tguyenn/drone-swarm/README.md

# Drone Swarm

This project is going to be a fully DIY drone swarm project based around ESP32 connectivity. There will be an ESP32 based handheld controller that will connect to ESP32 based drones over ESPNOW.
