tguyenn/drone-swarm/hardware/remote/controller.kicad_pcb

## KiCad design hardware/remote/controller.kicad_pcb (2026-08-26)

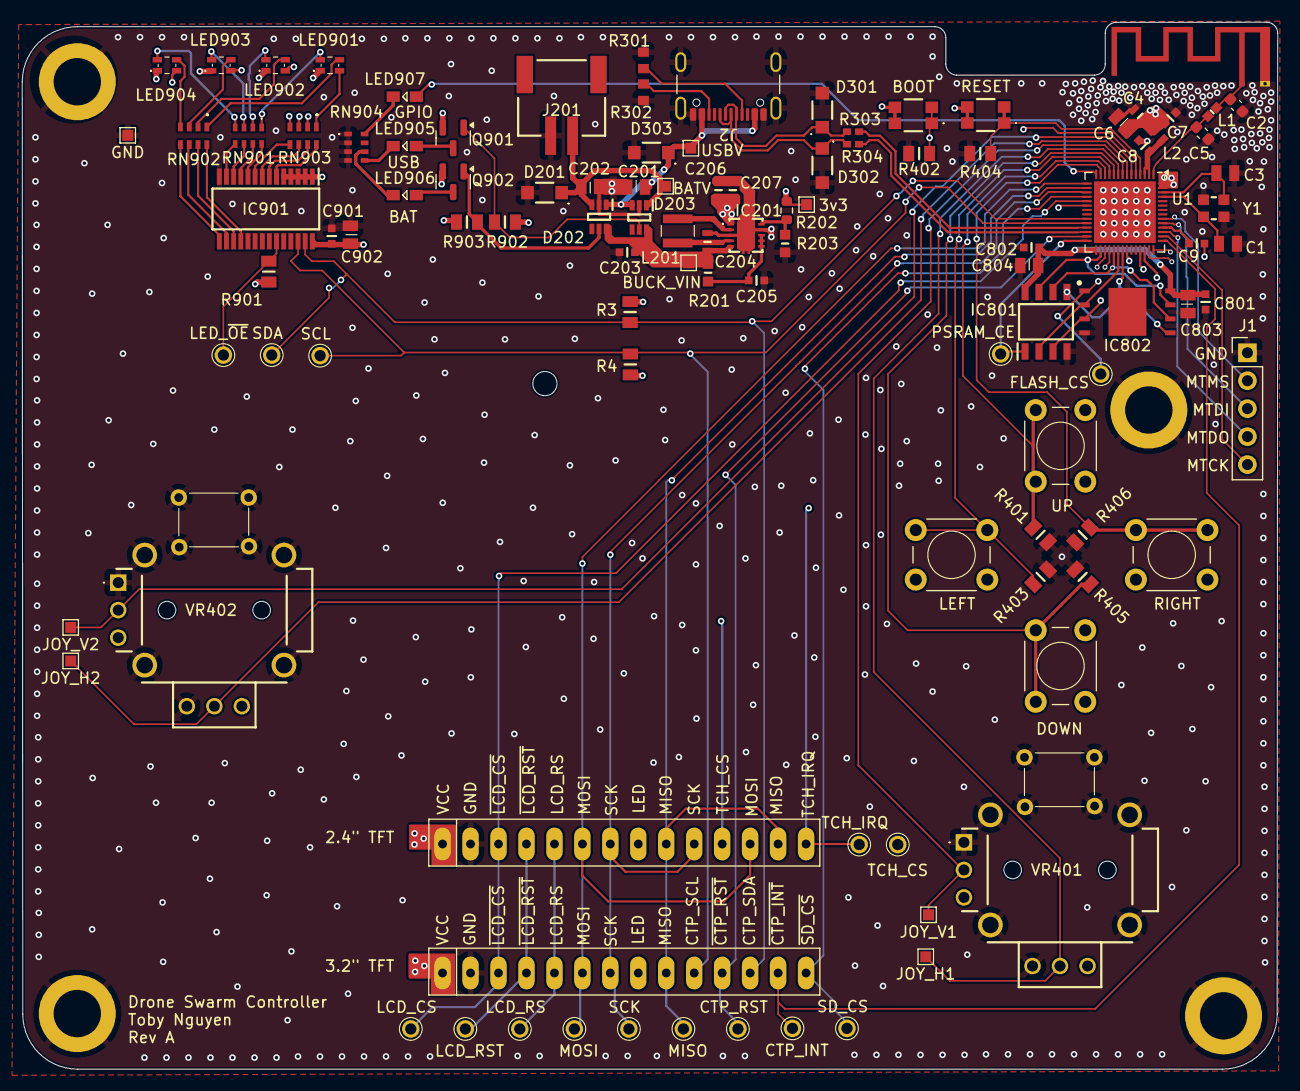
[picture p1: board controller.kicad_pcb from above]

Board: 4 copper layers, 114.0 x 95.1 mm, 113 parts (0 on the bottom side), 90 nets.

Parts:
AE1: Antenna_Chip; Texas_SWRA117D_2.4GHz_Left
C1, C3: 10p; CAPC2013X94N
C2, C5: 1p8; C_0603_1608Metric
C4, C204, C206, C207: 10u; CAPC1608X80N
C6, C201, C202, C803, C804, C902: 1u; CAPC2012X135N
C7, C8, C9, C203, C205, C801, C802, C901: u1; MAJx16
D201, D301, D302, D303: SMF5.0A_R1_00001; SMF50A_R1_00001
D202, D203: LM66100DCKR; SOP65P210X110-6N
H101: MountingHole; MountingHole_2.2mm_M2_DIN965
H102, H103, H104, H105: MountingHole_Pad; MountingHole_4.3mm_M4_ISO14580_Pad
IC201: TPS63000IDRCRQ1
IC801: 4677; SOIC127P600X175-8N
IC802: W25Q256JVEIQ; SON127P800X600X80-9N-D
IC901: PCA9685PW_Q900,118; SOP65P640X110-28N
J1: Conn_01x05_Pin; PinHeader_1x05_P2.54mm_Vertical
J2: USB_C_Receptacle_USB2.0_16P; USB_C_Receptacle_GCT_USB4105-xx-A_16P_TopMnt_Horizontal
J201: JST-PH Conn; 1769
L1: 3nH; INDC1006X65N
L2: 2nH; WE-KI_0603A30
L201: 2u2; NRS3015T2R2MNGHV
LED901, LED902, LED903, LED904: SM0605RGB
LED905, LED906, LED907: Orange; LEDM2214X140N
NT201: NetTie; NetTie-2_Pad0.3mm
Q901, Q902: IRLML6402TRPBF; SOT-23
R3, R4, R401, R402, R403, R404, R405, R406, R901, R902, R903: 10k; RESC2012X60N
R201: 100; RESC1608X55N
R202: 1M; R_0603_1608Metric
R203: 200k; RESC1608X55N
R301, R302: 5k1; RESC1608X50N
R303, R304: 27; RESC1005X40N
RN901, RN904: 150 Ohms; EXBV8V151JV
RN902, RN903: 100 Ohms; EXBU38
S401: BOOT; TL1030AF500AQJ
S402: RESET; TL1030AF500AQJ
SW401: UP; SW_PUSH_6mm
SW402: LEFT; SW_PUSH_6mm
SW403: DOWN; SW_PUSH_6mm
SW404: RIGHT; SW_PUSH_6mm
TP3: MOSI; 5000
TP5: SDA; 5000
TP6: MISO; 5000
TP8: SCL; 5000
TP9: SCK; 5000
TP10: CTP_RST; 5000
TP11: SD_CS; 5000
TP12: CTP_INT; 5000
TP13: LCD_CS; 5000
TP14: LED_~{OE}; 5000
TP15: LCD_RST; 5000
TP16: LCD_RS; 5000
TP17: TCH_CS; 5000
TP18: TCH_IRQ; 5000
TP201: BATV; TestPoint_Pad_1.0x1.0mm
TP202: GND; TestPoint_Pad_1.0x1.0mm
TP203: 3v3; TestPoint_Pad_1.0x1.0mm
TP204: USBV; TestPoint_Pad_1.0x1.0mm
TP205: BUCK_VIN; TestPoint_Pad_1.0x1.0mm
TP401: JOY_V1; TestPoint_Pad_1.0x1.0mm
TP402: JOY_H1; TestPoint_Pad_1.0x1.0mm
TP403: JOY_V2; TestPoint_Pad_1.0x1.0mm
TP404: JOY_H2; TestPoint_Pad_1.0x1.0mm
TP801: PSRAM_CE; 5000
TP802: FLASH_CS; 5000
U1: ESP32-S3; QFN-56-1EP_7x7mm_P0.4mm_EP5.6x5.6mm
U501, U502: 3.2inch_IPS_SPI_Module_ILI9341; TFT-320x240
VR401, VR402: RKJXV1224005
Y1: FH4000074Z

Connections:
+3V3: C4.1, C6.1, C7.1, C9.1, C206.1, C207.1, C901.1, C902.1, IC201.1 (VOUT), IC901.1 (A0), IC901.2 (A1), IC901.3 (A2), IC901.4 (A3), IC901.5 (A4), IC901.28 (VDD), L2.1, LED901.1 (ANODE), LED902.1 (ANODE), LED903.1 (ANODE), LED904.1 (ANODE), Q901.2 (S), Q902.2 (S), R3.2, R4.2, R202.1, R901.1, R902.2, R903.2, S401.2, S402.2, SW401.2, SW402.2, SW403.2, SW404.2, TP203.1, U1.20 (VDD3P3_RTC), U1.55 (VDDA), U1.56 (VDDA), U501.1 (VCC), U502.1 (VCC), VR401.A3 (CW_1), VR401.B3 (CW_2), VR402.A3 (CW_1), VR402.B3 (CW_2)
/ESP32/BUT_JOY.BUT_BOOT: R402.1, S401.1, U1.5 (GPIO0/BOOT)
/ESP32/BUT_JOY.BUT_DOWN: R405.1, SW403.1, U1.10 (GPIO5/ADC1_CH4)
/ESP32/BUT_JOY.BUT_LEFT: R403.1, SW402.1, U1.11 (GPIO6/ADC1_CH5)
/ESP32/BUT_JOY.BUT_RESET: R404.1, S402.1, U1.4 (CHIP_PU/RESET)
/ESP32/BUT_JOY.BUT_RIGHT: R406.1, SW404.1, U1.13 (GPIO8/ADC1_CH7)
/ESP32/BUT_JOY.BUT_UP: R401.1, SW401.1, U1.12 (GPIO7/ADC1_CH6)
/ESP32/BUT_JOY.JOY1_H: TP402.1, U1.9 (GPIO4/ADC1_CH3), VR401.B2 (WIPER_2)
/ESP32/BUT_JOY.JOY1_V: TP401.1, U1.8 (GPIO3/ADC1_CH2), VR401.A2 (WIPER_1)
/ESP32/BUT_JOY.JOY2_H: TP404.1, U1.7 (GPIO2/ADC1_CH1), VR402.B2 (WIPER_2)
/ESP32/BUT_JOY.JOY2_V: TP403.1, U1.6 (GPIO1/ADC1_CH0), VR402.A2 (WIPER_1)
/ESP32/I2C_CTP_LED.CTP_INT: TP12.1, U1.43 (GPIO38), U501.13 (~CTP_INT)
/ESP32/I2C_CTP_LED.CTP_RST: TP10.1, U1.27 (GPIO21), U501.11 (~CTP_RST)
/ESP32/I2C_CTP_LED.SCL: IC901.26 (SCL), R4.1, TP8.1, U1.24 (GPIO18/ADC2_CH7), U501.10 (CTP_SCL)
/ESP32/I2C_CTP_LED.SDA: IC901.27 (SDA), R3.1, TP5.1, U1.23 (GPIO17/ADC2_CH6), U501.12 (CTP_SDA)
/ESP32/I2C_CTP_LED.~OE: IC901.23 (~OE), R901.2, TP14.1, U1.36 (SPICLK_N/GPIO48)
/ESP32/LED_GPIO: LED907.2 (A), U1.14 (GPIO9/ADC1_CH8)
/ESP32/MEM.SCK: IC801.6 (SCLK), IC802.6 (CLK), U1.33 (SPICLK/GPIO30)
/ESP32/MEM.SIO0: IC801.5 (SI/SIO[0]), IC802.5 (DI_(IO0)), U1.35 (SPID/GPIO32)
/ESP32/MEM.SIO1: IC801.2 (SO/SIO[1]), IC802.2 (DO_(IO1)_1), U1.34 (SPIQ/GPIO31)
/ESP32/MEM.SIO2: IC801.3 (SIO[2]), IC802.3 (DO_(IO1)_2), U1.31 (SPIWP/GPIO28)
/ESP32/MEM.SIO3: IC801.7 (SIO[3]), IC802.7 (IO3), U1.30 (SPIHD/GPIO27)
/ESP32/MEM.~CE: IC801.1 (CE#), TP801.1, U1.28 (SPI_CS1/GPIO26)
/ESP32/MEM.~CS: IC802.1 (/CS), TP802.1, U1.32 (SPICS0/GPIO29)
/ESP32/MTCK: J1.5, U1.44 (MTCK/JTAG/GPIO39)
/ESP32/MTDI: J1.3, U1.47 (MTDI/JTAG/GPIO41)
/ESP32/MTDO: J1.4, U1.45 (MTDO/JTAG/GPIO40)
/ESP32/MTMS: J1.2, U1.48 (MTMS/JTAG/GPIO42)
/ESP32/SPI_LCD_SD.LCD_CS: TP13.1, U1.19 (GPIO14/ADC2_CH3), U501.3 (~LCD_CS), U502.3 (~LCD_CS)
/ESP32/SPI_LCD_SD.LCD_RS: TP16.1, U1.42 (GPIO37), U501.5 (LCD_RS), U502.5 (LCD_RS)
/ESP32/SPI_LCD_SD.LCD_RST: TP15.1, U1.41 (GPIO36), U501.4 (~LCD_RST), U502.4 (~LCD_RST)
/ESP32/SPI_LCD_SD.MISO: TP6.1, U1.16 (GPIO11/ADC2_CH0), U501.9 (MISO), U502.9 (MISO), U502.13 (T_DO)
/ESP32/SPI_LCD_SD.MOSI: TP3.1, U1.15 (GPIO10/ADC1_CH9), U501.6 (MOSI), U502.6 (MOSI), U502.12 (T_DIN)
/ESP32/SPI_LCD_SD.SCK: TP9.1, U1.17 (GPIO12/ADC2_CH1), U501.7 (SCK), U502.7 (SCK), U502.10 (T_CLK)
/ESP32/SPI_LCD_SD.SD_CS: TP11.1, U1.18 (GPIO13/ADC2_CH2), U501.14 (~SD_CS)
/ESP32/SPI_LCD_SD.TCH_CS: TP17.1, U1.40 (GPIO35), U502.11 (T_CS)
/ESP32/SPI_LCD_SD.TCH_IRQ: TP18.1, U1.39 (GPIO34), U502.14 (T_IRQ)
/ESP32/USB+: R304.2, U1.26 (GPIO20/USB_D+/ADC2_CH9)
/ESP32/USB-: R303.2, U1.25 (GPIO19/USB_D-/ADC2_CH8)
/LEDS/B1: LED901.2 (C_BLUE), RN903.1
/LEDS/B2: LED902.2 (C_BLUE), RN903.2
/LEDS/B3: LED903.2 (C_BLUE), RN903.3
/LEDS/B4: LED904.2 (C_BLUE), RN903.4
/LEDS/BAT_ST: D203.5 (ST), Q901.1 (G), R902.1
/LEDS/C_BLU1: IC901.6 (LED0), RN903.8
/LEDS/C_BLU2: IC901.7 (LED1), RN903.7
/LEDS/C_BLU3: IC901.8 (LED2), RN903.6
/LEDS/C_BLU4: IC901.9 (LED3), RN903.5
/LEDS/C_GRN1: IC901.18 (LED11), RN902.8
/LEDS/C_GRN2: IC901.17 (LED10), RN902.7
/LEDS/C_GRN3: IC901.16 (LED9), RN902.6
/LEDS/C_GRN4: IC901.15 (LED8), RN902.5
/LEDS/C_RED1: IC901.10 (LED4), RN901.8
/LEDS/C_RED2: IC901.11 (LED5), RN901.7
/LEDS/C_RED3: IC901.12 (LED6), RN901.6
/LEDS/C_RED4: IC901.13 (LED7), RN901.5
/LEDS/G1: LED901.4 (C_GREEN), RN902.1
/LEDS/G2: LED902.4 (C_GREEN), RN902.2
/LEDS/G3: LED903.4 (C_GREEN), RN902.3
/LEDS/G4: LED904.4 (C_GREEN), RN902.4
/LEDS/R1: LED901.3 (C_RED), RN901.1
/LEDS/R2: LED902.3 (C_RED), RN901.2
/LEDS/R3: LED903.3 (C_RED), RN901.3
/LEDS/R4: LED904.3 (C_RED), RN901.4
/LEDS/USBC_ST: D202.5 (ST), Q902.1 (G), R903.1
/POWER/BAT_VBUS: C202.1, D201.1 (K), D202.3 (~CE), D203.1 (VIN), J201.1, TP201.1
/POWER/BUCK_VIN: C203.1, C204.1, D202.6 (VOUT), D203.6 (VOUT), IC201.5 (VIN), R201.1, TP205.1
/POWER/USBC_VBUS: C201.1, D202.1 (VIN), D203.3 (~CE), D303.1 (K), J2.A4 (VBUS), J2.A9 (VBUS), J2.B4 (VBUS), J2.B9 (VBUS), TP204.1
/USBC/CC1: J2.A5 (CC1), R301.1
/USBC/CC2: J2.B5 (CC2), R302.1
/USBC/D+: D302.1 (K), J2.A6 (D+), J2.B6 (D+), R304.1
/USBC/D-: D301.1 (K), J2.A7 (D-), J2.B7 (D-), R303.1
GND: AE1.2 (PCB_Trace), C1.2, C2.2, C3.2, C4.2, C5.2, C6.2, C7.2, C8.2, C201.2, C202.2, C203.2, C205.2, C801.2, C802.2, C803.2, C804.2, C901.2, C902.2, D201.2 (A), D202.2 (GND), D203.2 (GND), D301.2 (A), D302.2 (A), D303.2 (A), H102.1, H103.1, H104.1, H105.1, IC201.9 (GND), IC801.4 (VSS), IC802.4 (GND), IC802.9 (EP), IC901.14 (VSS), J1.1, J2.A1 (GND), J2.A12 (GND), J2.B1 (GND), J2.B12 (GND), J2.S1 (SHIELD), J201.2, NT201.1, R203.2, R301.2, R302.2, R401.2, R402.2, R403.2, R404.2, R405.2, R406.2, RN904.1, RN904.2, RN904.3, RN904.4, TP202.1, U1.57 (GND), U501.2 (GND), U502.2 (GND), VR401.1 (MH1), VR401.2 (MH2), VR401.3 (MH3), VR401.4 (MH4), VR401.5 (BUT_0), VR401.6 (BUT_1), VR401.A1 (CCW_1), VR401.B1 (CCW_2), VR402.1 (MH1), VR402.2 (MH2), VR402.3 (MH3), VR402.4 (MH4), VR402.5 (BUT_0), VR402.6 (BUT_1), VR402.A1 (CCW_1), VR402.B1 (CCW_2), Y1.2 (GND), Y1.4 (GND)
GNDPWR: C204.2, C206.2, C207.2, IC201.3 (PGND_1), IC201.11 (PGND_2), IC201.12 (PGND_3), IC201.13 (PGND_4), IC201.14 (PGND_5), IC201.15 (PGND_6), NT201.2
unnamed: AE1.1 (FEED), C2.1, L1.1
unnamed: C205.1, IC201.6 (EN), IC201.7 (PS/SYNC), IC201.8 (VINA), R201.2
unnamed: IC201.10 (FB), R202.2, R203.1
unnamed: IC201.4 (L1), L201.1
unnamed: IC201.2 (L2), L201.2
unnamed: LED905.2 (A), Q901.3 (D)
unnamed: LED905.1 (K), RN904.5
unnamed: LED906.2 (A), Q902.3 (D)
unnamed: LED906.1 (K), RN904.6
unnamed: LED907.1 (K), RN904.8
unnamed: C5.1, L1.2, U1.1 (LNA_IN/RF)
unnamed: C9.2, U1.46 (VDD3P3_CPU)
unnamed: C1.1, U1.53 (XTAL_N), Y1.3 (XOUT)
unnamed: C3.1, U1.54 (XTAL_P), Y1.1 (XIN)
VDD3P3: C8.1, L2.2, U1.2 (VDD3P3), U1.3 (VDD3P3)
VDD_SPI: C801.1, C802.1, C803.1, C804.1, IC801.8 (VCC), IC802.8 (VCC), U1.29 (VDD_SPI)
