tguyenn/drone-swarm/hardware/flight_controller/drone.kicad_pcb

## KiCad design hardware/flight_controller/drone.kicad_pcb (2025-09-21)

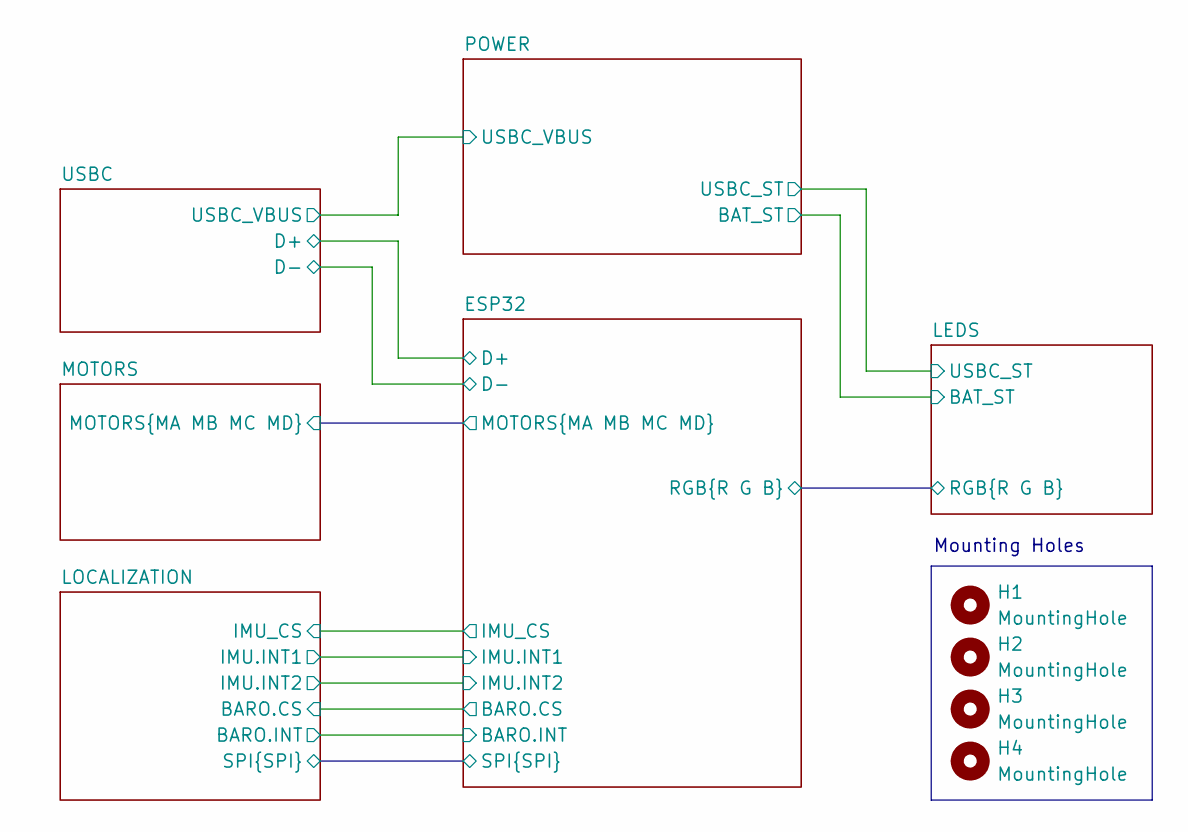
[picture p2: schematic drone.kicad_sch, Remote Controller]

Parts:
H1, H2, H3, H4: MountingHole; MountingHole_2.1mm

Notes on the sheet:
Mounting Holes

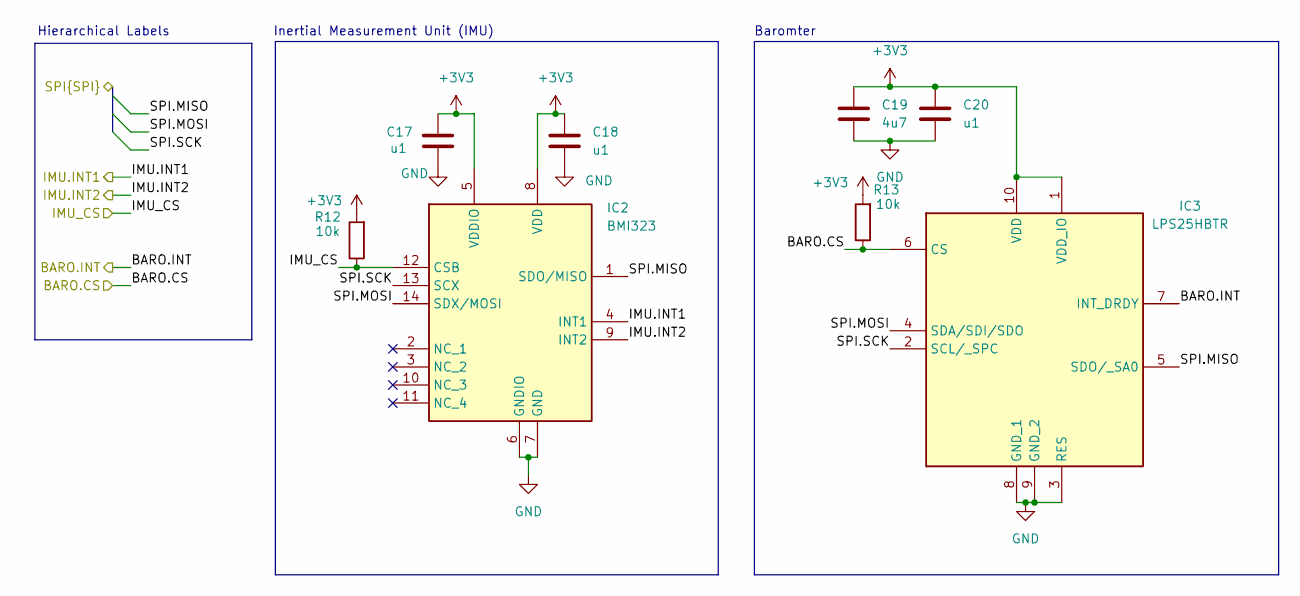
[picture p3: schematic IMU.kicad_sch]

Parts:
C17, C18, C20: u1; MAJx16; Mouser Part Number 963-MAJCH168BB7104KT
C19: 4u7; CAPC1608X90N; Manufacturer_Part_Number AMK107BJ475MA-T
IC2: BMI323; Mouser Part Number 262-BMI323
IC3: LPS25HBTR; Mouser Part Number 511-LPS25HBTR
R12, R13: 10k; RESC2012X60N; Manufacturer_Part_Number ASC0805-10KFT5; Mouser Part Number 756-ASC0805-10KFT5

Connections:
+3V3: C17.1, C18.1, C19.1, C20.1, IC2.5 (VDDIO), IC2.8 (VDD), IC3.1 (VDD_IO), IC3.10 (VDD), R12.2, R13.2; also elsewhere on the board
/ESP32/BARO.CS: IC3.6 (CS), R13.1; also elsewhere on the board
/ESP32/BARO.INT: IC3.7 (INT_DRDY); also elsewhere on the board
/ESP32/IMU.INT1: IC2.4 (INT1); also elsewhere on the board
/ESP32/IMU.INT2: IC2.9 (INT2); also elsewhere on the board
/ESP32/IMU_CS: IC2.12 (CSB), R12.1; also elsewhere on the board
/ESP32/SPI.MISO: IC2.1 (SDO/MISO), IC3.5 (SDO/_SA0); also elsewhere on the board
/ESP32/SPI.MOSI: IC2.14 (SDX/MOSI), IC3.4 (SDA/SDI/SDO); also elsewhere on the board
/ESP32/SPI.SCK: IC2.13 (SCX), IC3.2 (SCL/_SPC); also elsewhere on the board
GND: C17.2, C18.2, C19.2, C20.2, IC2.6 (GNDIO), IC2.7 (GND), IC3.3 (RES), IC3.8 (GND_1), IC3.9 (GND_2); also elsewhere on the board

Notes on the sheet:
Baromter
Hierarchical Labels
Inertial Measurement Unit (IMU)

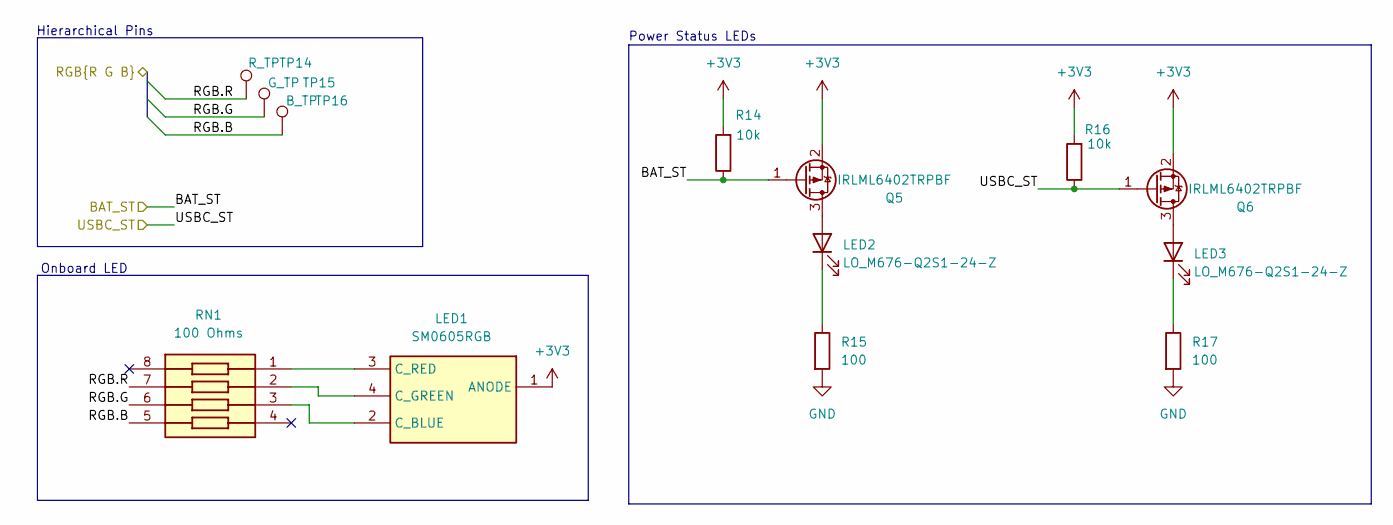
[picture p4: schematic LEDS.kicad_sch]

Parts:
LED1: SM0605RGB; Mouser Part Number 749-SM0605TCRGB
LED2, LED3: LO_M676-Q2S1-24-Z; LEDM2214X140N; Mouser Part Number 720-LOM676Q2S124Z
Q5, Q6: IRLML6402TRPBF; SOT-23; Mouser Part Number 942-IRLML6402TRPBF
R14, R16: 10k; RESC2012X60N; Manufacturer_Part_Number ASC0805-10KFT5; Mouser Part Number 756-ASC0805-10KFT5
R15, R17: 100; RESC1608X55N; Mouser Part Number 755-ESR03EZPF1000
RN1: 100 Ohms; EXBU38; Mouser Part Number 667-EXB-U38101JV
TP14: R_TP; TestPoint_Pad_1.0x1.0mm
TP15: G_TP; TestPoint_Pad_1.0x1.0mm
TP16: B_TP; TestPoint_Pad_1.0x1.0mm

Connections:
+3V3: LED1.1 (ANODE), Q5.2 (S), Q6.2 (S), R14.2, R16.2; also elsewhere on the board
/ESP32/RGB.B: RN1.5, TP16.1; also elsewhere on the board
/ESP32/RGB.G: RN1.6, TP15.1; also elsewhere on the board
/ESP32/RGB.R: RN1.7, TP14.1; also elsewhere on the board
/LEDS/BAT_ST: Q5.1 (G), R14.1; also elsewhere on the board
/LEDS/USBC_ST: Q6.1 (G), R16.1; also elsewhere on the board
GND: R15.2, R17.2; also elsewhere on the board
unnamed: LED1.2 (C_BLUE), RN1.3
unnamed: LED1.4 (C_GREEN), RN1.2
unnamed: LED1.3 (C_RED), RN1.1
unnamed: LED2.2 (A), Q5.3 (D)
unnamed: LED2.1 (K), R15.1
unnamed: LED3.2 (A), Q6.3 (D)
unnamed: LED3.1 (K), R17.1

Notes on the sheet:
Onboard LED
Hierarchical Pins
Power Status LEDs

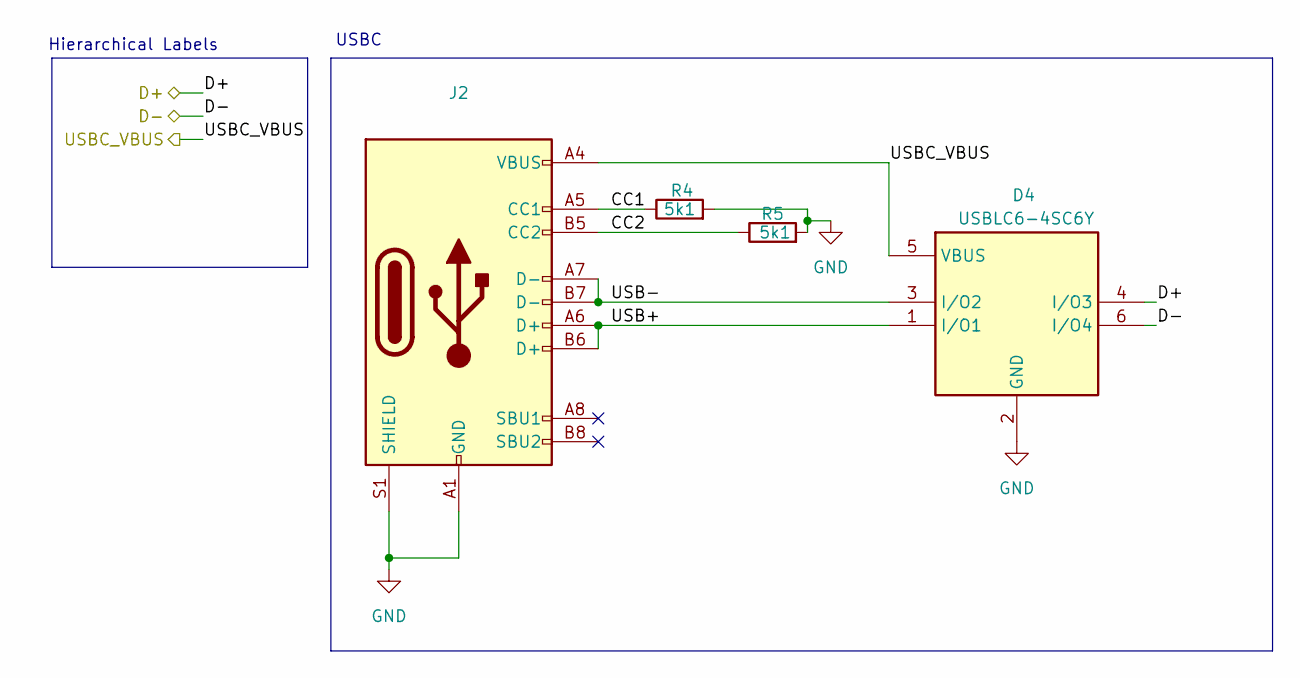
[picture p5: schematic USBC.kicad_sch]

Parts:
D4: USBLC6-4SC6Y; SOT95P280X145-6N; Mouser Part Number 511-USBLC6-4SC6Y
J2: USB_C_Receptacle_GCT_USB4105-xx-A_16P_TopMnt_Horizontal
R4, R5: 5k1; RESC1608X50N; Mouser Part Number 71-CRCW06035K10FKEC

Connections:
/ESP32/D+: D4.4 (I/O3); also elsewhere on the board
/ESP32/D-: D4.6 (I/O4); also elsewhere on the board
/POWER/USBC_VBUS: D4.5 (VBUS), J2.A4 (VBUS), J2.A9 (VBUS), J2.B4 (VBUS), J2.B9 (VBUS); also elsewhere on the board
/USBC/CC1: J2.A5 (CC1), R4.1
/USBC/CC2: J2.B5 (CC2), R5.1
/USBC/USB+: D4.1 (I/O1), J2.A6 (D+), J2.B6 (D+)
/USBC/USB-: D4.3 (I/O2), J2.A7 (D-), J2.B7 (D-)
GND: D4.2 (GND), J2.A1 (GND), J2.A12 (GND), J2.B1 (GND), J2.B12 (GND), J2.S1 (SHIELD), R4.2, R5.2; also elsewhere on the board

Notes on the sheet:
USBC
Hierarchical Labels

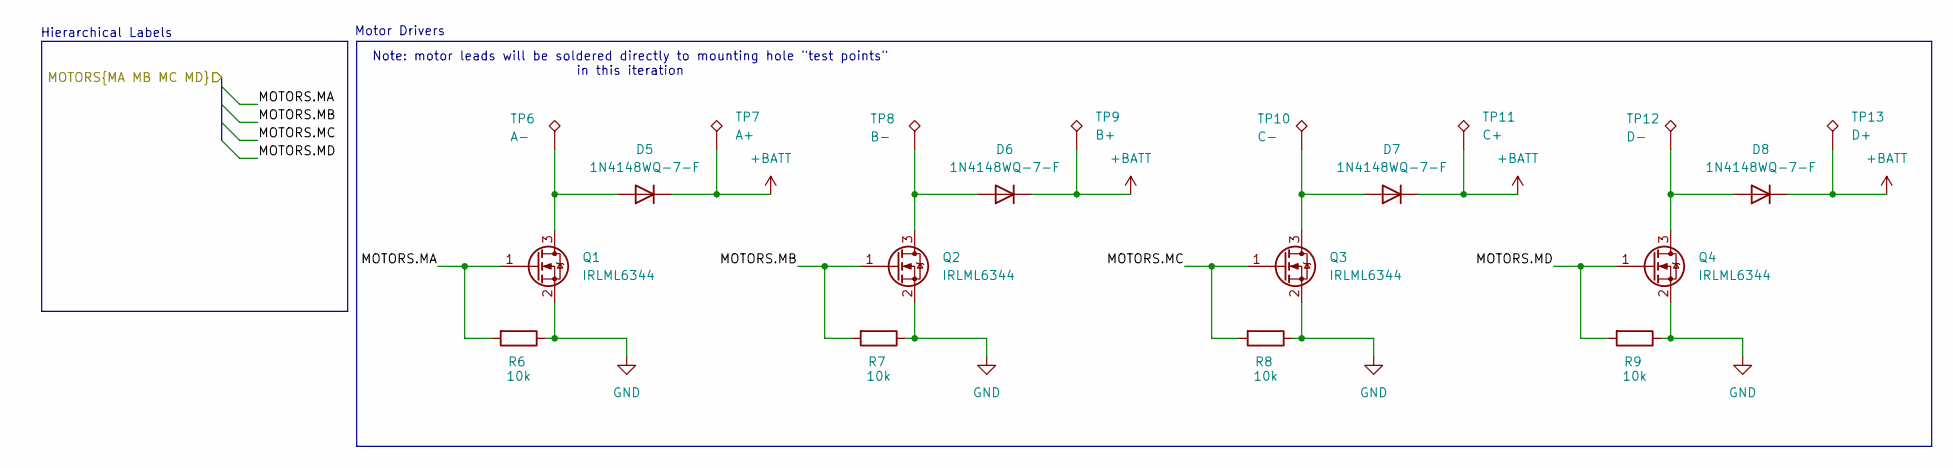
[picture p6: schematic MOTORS.kicad_sch]

Parts:
D5, D6, D7, D8: 1N4148WQ-7-F; SOD3716X145N; Mouser Part Number 621-1N4148WQ-7-F
Q1, Q2, Q3, Q4: IRLML6344; SOT-23
R6, R7, R8, R9: 10k; RESC2012X60N; Manufacturer_Part_Number ASC0805-10KFT5; Mouser Part Number 756-ASC0805-10KFT5
TP6: A-; Motor solder point
TP7: A+; Motor solder point
TP8: B-; Motor solder point
TP9: B+; Motor solder point
TP10: C-; Motor solder point
TP11: C+; Motor solder point
TP12: D-; Motor solder point
TP13: D+; Motor solder point

Connections:
+BATT: D5.1 (K), D6.1 (K), D7.1 (K), D8.1 (K), TP7.1, TP9.1, TP11.1, TP13.1; also elsewhere on the board
/ESP32/MOTORS.MA: Q1.1 (G), R6.2; also elsewhere on the board
/ESP32/MOTORS.MB: Q2.1 (G), R7.2; also elsewhere on the board
/ESP32/MOTORS.MC: Q3.1 (G), R8.2; also elsewhere on the board
/ESP32/MOTORS.MD: Q4.1 (G), R9.2; also elsewhere on the board
GND: Q1.2 (S), Q2.2 (S), Q3.2 (S), Q4.2 (S), R6.1, R7.1, R8.1, R9.1; also elsewhere on the board
unnamed: D5.2 (A), Q1.3 (D), TP6.1
unnamed: D6.2 (A), Q2.3 (D), TP8.1
unnamed: D7.2 (A), Q3.3 (D), TP10.1
unnamed: D8.2 (A), Q4.3 (D), TP12.1

Notes on the sheet:
Motor Drivers
Note: motor leads will be soldered directly to mounting hole "test points" in this iteration
Hierarchical Labels

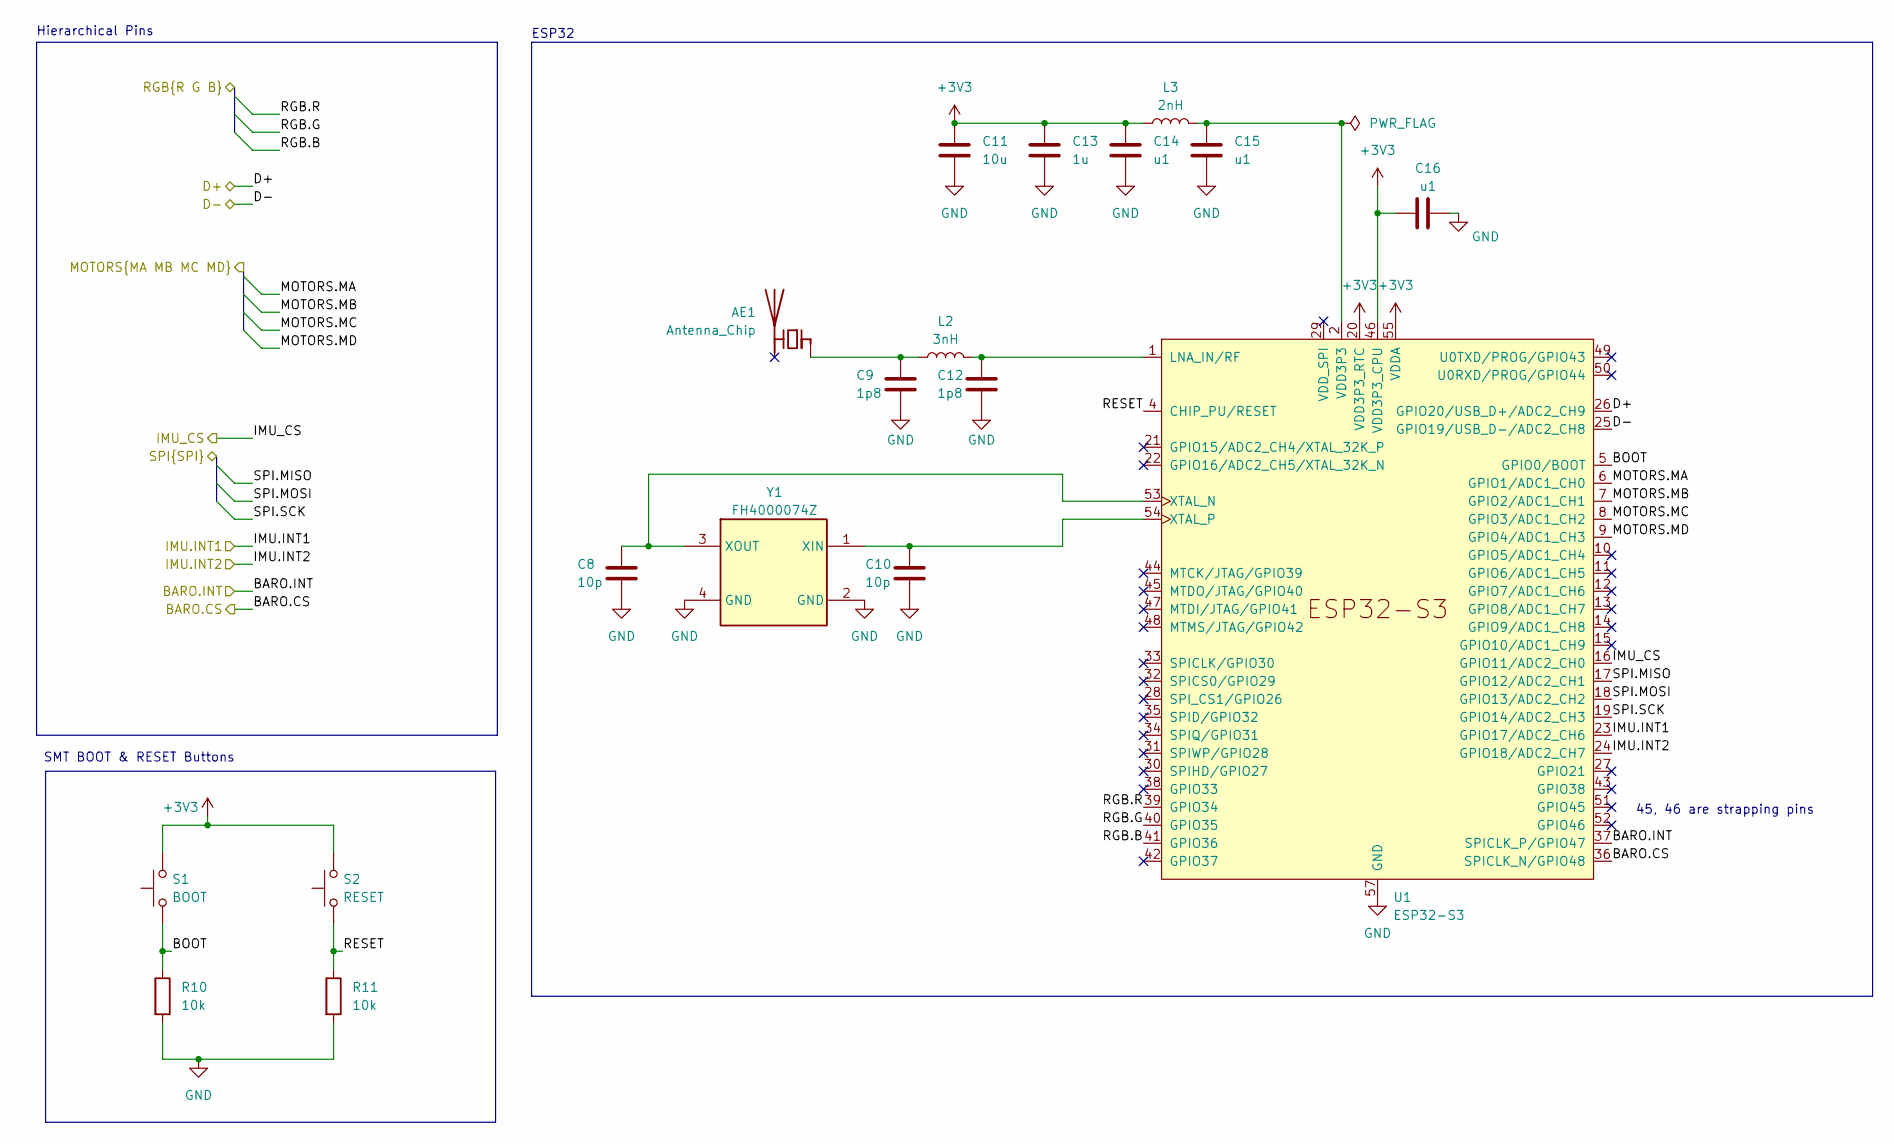
[picture p7: schematic ESP32.kicad_sch]

Parts:
AE1: Antenna_Chip; AANI-CH-0133
C8, C10: 10p; CAPC2013X94N; Mouser Part Number 581-08053A100JAT2A
C9, C12: 1p8; C_0603_1608Metric; Mouser Part Number 581-KGQ15ACG2A1R8BT
C11: 10u; CAPC1608X80N; Mouser Part Number 810-C1608X7T1A106M08
C13: 1u; CAPC2012X135N; Mouser Part Number 791-0805X105K160CT
C14, C15, C16: u1; MAJx16; Mouser Part Number 963-MAJCH168BB7104KT
L2: 3nH; INDC1006X65N; Manufacturer_Part_Number AIMC-0402HQ-3N0B-T
L3: 2nH; WE-KI_0603A30; Mouser Part Number 710-744761020A
R10, R11: 10k; RESC2012X60N; Mouser Part Number 756-ASC0805-10KFT5
S1: BOOT; TL1030AF500AQJ; Mouser Part Number 612-TL1030AF500AQJ
S2: RESET; TL1030AF500AQJ; Mouser Part Number 612-TL1030AF500AQJ
U1: ESP32-S3; QFN-56-1EP_7x7mm_P0.4mm_EP5.6x5.6mm; Mouser Part Number 356-ESP32-S3
Y1: FH4000074Z; Mouser Part Number 729-FH4000074Z

Connections:
+3V3: C11.1, C13.1, C14.1, C16.1, L3.1, S1.2, S2.2, U1.20 (VDD3P3_RTC), U1.46 (VDD3P3_CPU), U1.55 (VDDA), U1.56 (VDDA); also elsewhere on the board
/ESP32/BARO.CS: U1.36 (SPICLK_N/GPIO48); also elsewhere on the board
/ESP32/BARO.INT: U1.37 (SPICLK_P/GPIO47); also elsewhere on the board
/ESP32/BOOT: R10.1, S1.1, U1.5 (GPIO0/BOOT)
/ESP32/D+: U1.26 (GPIO20/USB_D+/ADC2_CH9); also elsewhere on the board
/ESP32/D-: U1.25 (GPIO19/USB_D-/ADC2_CH8); also elsewhere on the board
/ESP32/IMU.INT1: U1.23 (GPIO17/ADC2_CH6); also elsewhere on the board
/ESP32/IMU.INT2: U1.24 (GPIO18/ADC2_CH7); also elsewhere on the board
/ESP32/IMU_CS: U1.16 (GPIO11/ADC2_CH0); also elsewhere on the board
/ESP32/MOTORS.MA: U1.6 (GPIO1/ADC1_CH0); also elsewhere on the board
/ESP32/MOTORS.MB: U1.7 (GPIO2/ADC1_CH1); also elsewhere on the board
/ESP32/MOTORS.MC: U1.8 (GPIO3/ADC1_CH2); also elsewhere on the board
/ESP32/MOTORS.MD: U1.9 (GPIO4/ADC1_CH3); also elsewhere on the board
/ESP32/RESET: R11.1, S2.1, U1.4 (CHIP_PU/RESET)
/ESP32/RGB.B: U1.41 (GPIO36); also elsewhere on the board
/ESP32/RGB.G: U1.40 (GPIO35); also elsewhere on the board
/ESP32/RGB.R: U1.39 (GPIO34); also elsewhere on the board
/ESP32/SPI.MISO: U1.17 (GPIO12/ADC2_CH1); also elsewhere on the board
/ESP32/SPI.MOSI: U1.18 (GPIO13/ADC2_CH2); also elsewhere on the board
/ESP32/SPI.SCK: U1.19 (GPIO14/ADC2_CH3); also elsewhere on the board
GND: C8.2, C9.2, C10.2, C11.2, C12.2, C13.2, C14.2, C15.2, C16.2, R10.2, R11.2, U1.57 (GND), Y1.2 (GND), Y1.4 (GND); also elsewhere on the board
unnamed: AE1.1 (FEED), C9.1, L2.1
unnamed: C12.1, L2.2, U1.1 (LNA_IN/RF)
unnamed: C8.1, U1.53 (XTAL_N), Y1.3 (XOUT)
unnamed: C10.1, U1.54 (XTAL_P), Y1.1 (XIN)
VDD3P3: C15.1, L3.2, U1.2 (VDD3P3), U1.3 (VDD3P3)

Notes on the sheet:
ESP32
Hierarchical Pins
SMT BOOT & RESET Buttons
45, 46 are strapping pins

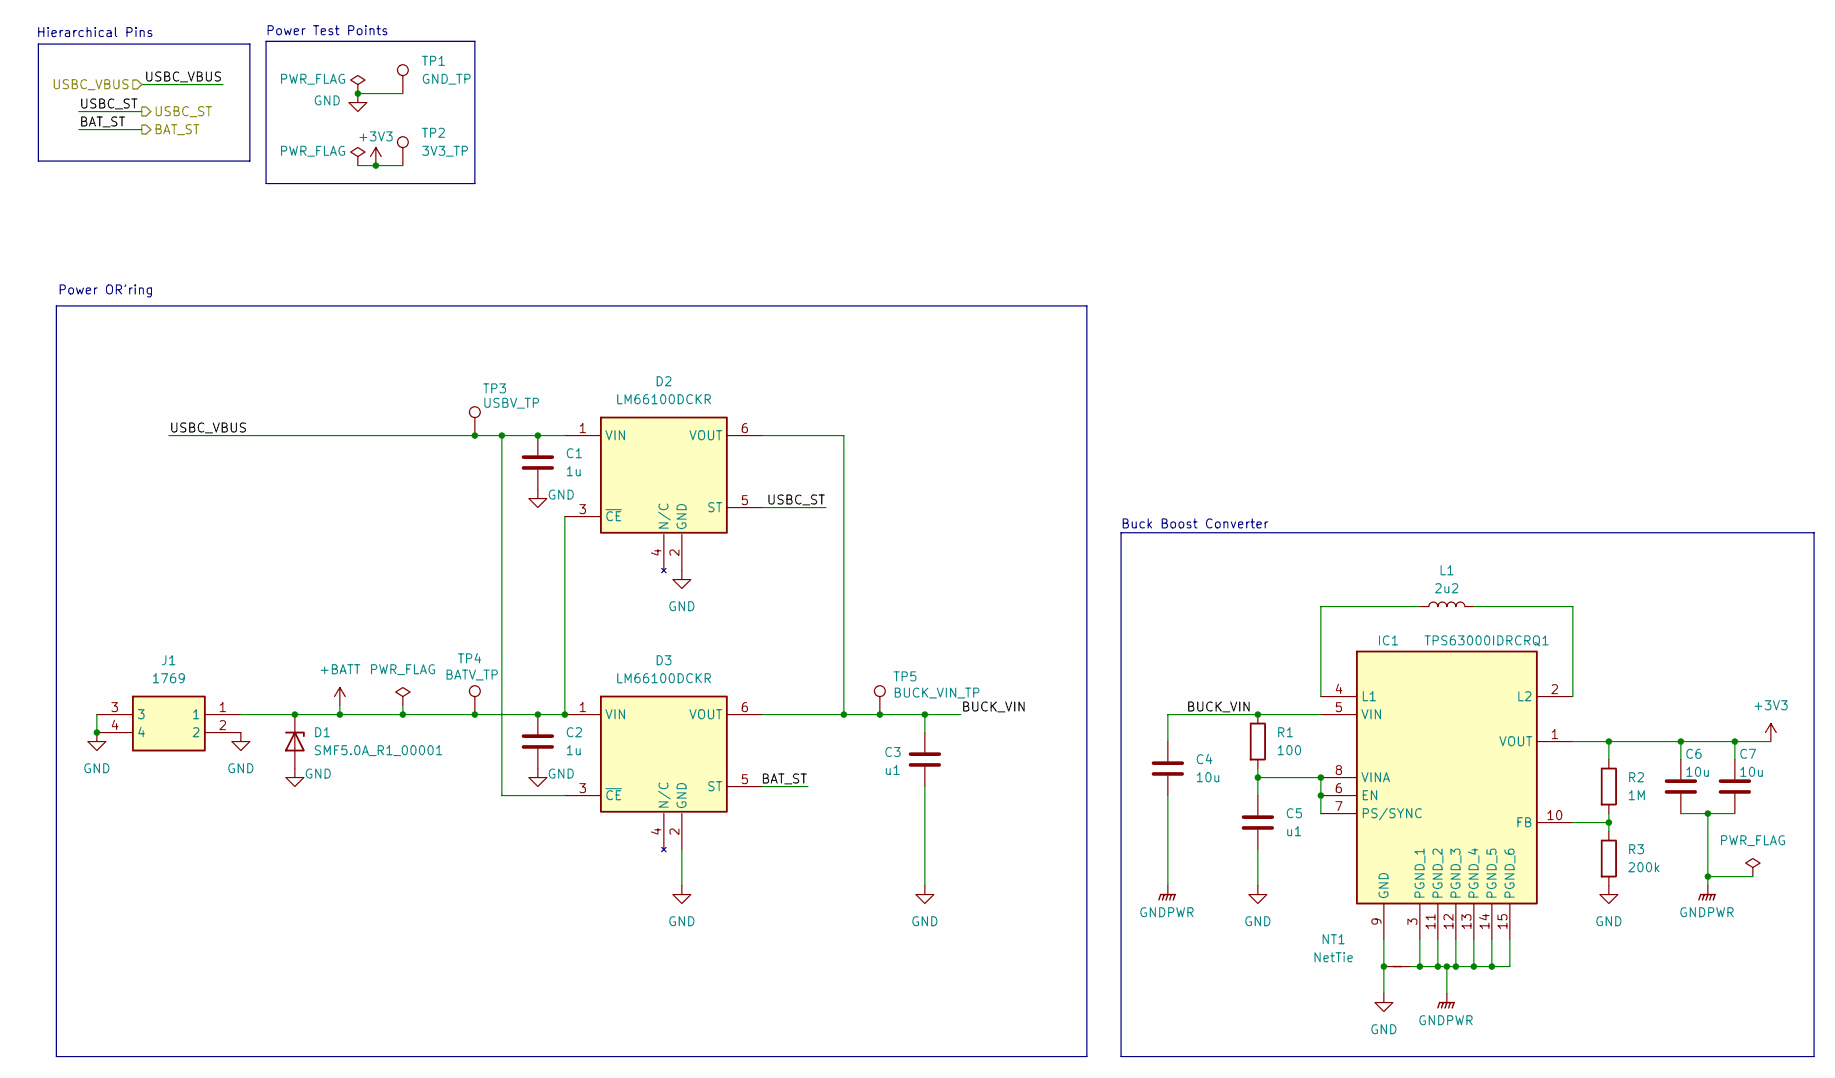
[picture p8: schematic POWER.kicad_sch]

Parts:
C1, C2: 1u; CAPC2012X135N; Mouser Part Number 791-0805X105K160CT
C3, C5: u1; MAJx16; Manufacturer_Part_Number MAJCH168BB7104KTEA01; Mouser Part Number 963-MAJCH168BB7104KT
C4, C6, C7: 10u; CAPC1608X80N; Mouser Part Number 810-C1608X7T1A106M08
D1: SMF5.0A_R1_00001; SMF50A_R1_00001; Mouser Part Number 241-SMF5.0A_R1_00001
D2, D3: LM66100DCKR; SOP65P210X110-6N; Mouser Part Number 595-LM66100DCKR
IC1: TPS63000IDRCRQ1; Mouser Part Number 595-TPS63000IDRCRQ1
J1: 1769; Mouser Part Number 485-1769
L1: 2u2; NRS3015T2R2MNGHV; Mouser Part Number 963-NRS3015T2R2MNGHV
NT1: NetTie; custom_net_tie
R1: 100; RESC1608X55N; Mouser Part Number 755-ESR03EZPF1000
R2: 1M; RESC1608X55N; Mouser Part Number 755-SFR03EZPJ105
R3: 200k; RESC1608X55N; Mouser Part Number 755-KTR03EZPJ204
TP1: GND_TP; TestPoint_Pad_1.0x1.0mm
TP2: 3V3_TP; TestPoint_Pad_1.0x1.0mm
TP3: USBV_TP; TestPoint_Pad_1.0x1.0mm
TP4: BATV_TP; TestPoint_Pad_1.0x1.0mm
TP5: BUCK_VIN_TP; TestPoint_Pad_1.0x1.0mm

Connections:
+3V3: C6.1, C7.1, IC1.1 (VOUT), R2.1, TP2.1; also elsewhere on the board
+BATT: C2.1, D1.1 (K), D2.3 (~CE), D3.1 (VIN), J1.1, TP4.1; also elsewhere on the board
/LEDS/BAT_ST: D3.5 (ST); also elsewhere on the board
/LEDS/USBC_ST: D2.5 (ST); also elsewhere on the board
/POWER/BUCK_VIN: C3.1, C4.1, D2.6 (VOUT), D3.6 (VOUT), IC1.5 (VIN), R1.1, TP5.1
/POWER/USBC_VBUS: C1.1, D2.1 (VIN), D3.3 (~CE), TP3.1; also elsewhere on the board
GND: C1.2, C2.2, C3.2, C5.2, D1.2 (A), D2.2 (GND), D3.2 (GND), IC1.9 (GND), J1.2, J1.3, J1.4, NT1.1, R3.2, TP1.1; also elsewhere on the board
GNDPWR: C4.2, C6.2, C7.2, IC1.3 (PGND_1), IC1.11 (PGND_2), IC1.12 (PGND_3), IC1.13 (PGND_4), IC1.14 (PGND_5), IC1.15 (PGND_6), NT1.2
unnamed: C5.1, IC1.6 (EN), IC1.7 (PS/SYNC), IC1.8 (VINA), R1.2
unnamed: IC1.10 (FB), R2.2, R3.1
unnamed: IC1.4 (L1), L1.1
unnamed: IC1.2 (L2), L1.2

Notes on the sheet:
Power Test Points
Buck Boost Converter
Power OR'ring
Hierarchical Pins

Board: 4 copper layers, 89 parts (9 on the bottom side), 51 nets, no tracks yet.
