tguyenn/drone-swarm/(commit log)

2025-06-20 rev1 init. set up files for kicad
    [BUTTONS.kicad_sch, ESP32.kicad_sch, JOYSTICK_BUTTONS.kicad_sch, LCD.kicad_sch, MEMORY.kicad_sch, POWER.kicad_sch, USBC.kicad_sch, USB_UART.kicad_sch]
2025-06-21 added LED IC's and USB UART bridge
    [ESP32.kicad_sch, JOYSTICK_BUTTONS.kicad_sch, LCD.kicad_sch, LEDS.kicad_sch, MEMORY.kicad_sch, POWER.kicad_sch, USBC.kicad_sch, USB_UART.kicad_sch]
2025-06-23 fixed bus stuff
    [ESP32.kicad_sch, JOYSTICK_BUTTONS.kicad_sch, LCD.kicad_sch, LEDS.kicad_sch, USBC.kicad_sch, USB_UART.kicad_sch, controller.kicad_sch]
2025-06-23 added memory and fixed gpio pins
    [ESP32.kicad_sch, LCD.kicad_sch, LEDS.kicad_sch, MEMORY.kicad_sch, controller.kicad_pcb, controller.kicad_sch]
2025-07-04 modified power circuitry
    [ESP32.kicad_sch, JOYSTICK_BUTTONS.kicad_sch, LCD.kicad_sch, LEDS.kicad_sch, MEMORY.kicad_sch, POWER.kicad_sch, USBC.kicad_sch, USB_UART.kicad_sch]
2025-07-04 finished first rev of controller schematic minus actually finding passive components. moved some features to rev2 todo
    [ESP32.kicad_sch, JOYSTICK_BUTTONS.kicad_sch, LCD.kicad_sch, LEDS.kicad_sch, MEMORY.kicad_sch, POWER.kicad_sch, USBC.kicad_sch, USB_UART.kicad_sch]
2025-07-06 Moved LEDs around. Replaced some discrete resistors with resistor arrays. Added mounting holes. Added. Added a lot of actual components for passive elements
    [ESP32.kicad_sch, JOYSTICK_BUTTONS.kicad_sch, LCD.kicad_sch, LEDS.kicad_sch, MEMORY.kicad_sch, POWER.kicad_sch, USBC.kicad_sch, USB_UART.kicad_sch]
2025-07-06 ERC good to go. grouped all components on pcb
    [ESP32.kicad_sch, JOYSTICK_BUTTONS.kicad_sch, LCD.kicad_sch, LEDS.kicad_sch, MEMORY.kicad_sch, POWER.kicad_sch, USBC.kicad_sch, USB_UART.kicad_sch]
2025-07-07 fixed 3d models. rounded edges of pcb
    [ESP32.kicad_sch, JOYSTICK_BUTTONS.kicad_sch, LEDS.kicad_sch, POWER.kicad_sch, USBC.kicad_sch, USB_UART.kicad_sch, controller.kicad_pcb]
2025-07-07 man im tired
    [LCD.kicad_sch, USBC.kicad_sch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]
2025-07-11 kicad why crash
    [ESP32.kicad_sch, POWER.kicad_sch, controller.kicad_pcb]
2025-07-12 save before nuke
    [BUTTONS.kicad_sch, ESP32.kicad_sch, IMU.kicad_sch, JOYSTICK_BUTTONS.kicad_sch, LCD.kicad_sch, LEDS.kicad_sch, MEMORY.kicad_sch, MOTORS.kicad_sch]
2025-07-12 done but need to add stitching vias
    [ESP32.kicad_sch, JOYSTICK_BUTTONS.kicad_sch, LEDS.kicad_sch, MEMORY.kicad_sch, POWER.kicad_sch, controller.kicad_pcb, drone.kicad_pcb]
2025-07-27 clean up DRC. need to add stitching vias and figure out why inner ground plane isnt connected to F.Cu pour
    [ESP32.kicad_sch, JOYSTICK_BUTTONS.kicad_sch, LCD.kicad_sch, LEDS.kicad_sch, POWER.kicad_sch, USBC.kicad_sch, USB_UART.kicad_sch, controller.kicad_pcb]
2025-09-02 save before axing motor driver ic's
    [ESP32.kicad_sch, IMU.kicad_sch, LEDS.kicad_sch, MOTORS.kicad_sch, POWER.kicad_sch, USBC.kicad_sch, USB_UART.kicad_sch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]
2025-09-21 axed motor drivers. finished layout for drone but need to review overall system design after reading some stuff
    [ESP32.kicad_sch, IMU.kicad_sch, LEDS.kicad_sch, MOTORS.kicad_sch, POWER.kicad_sch, USBC.kicad_sch, drone.kicad_pcb, drone.kicad_sch]
2025-11-19 Removed controller firmware build folder. Added basic LED PWM functionality
